alexsomesan/temp-controller/hardware/fridge-controller.kicad_pcb

## KiCad design hardware/fridge-controller.kicad_pcb (2021-08-09)

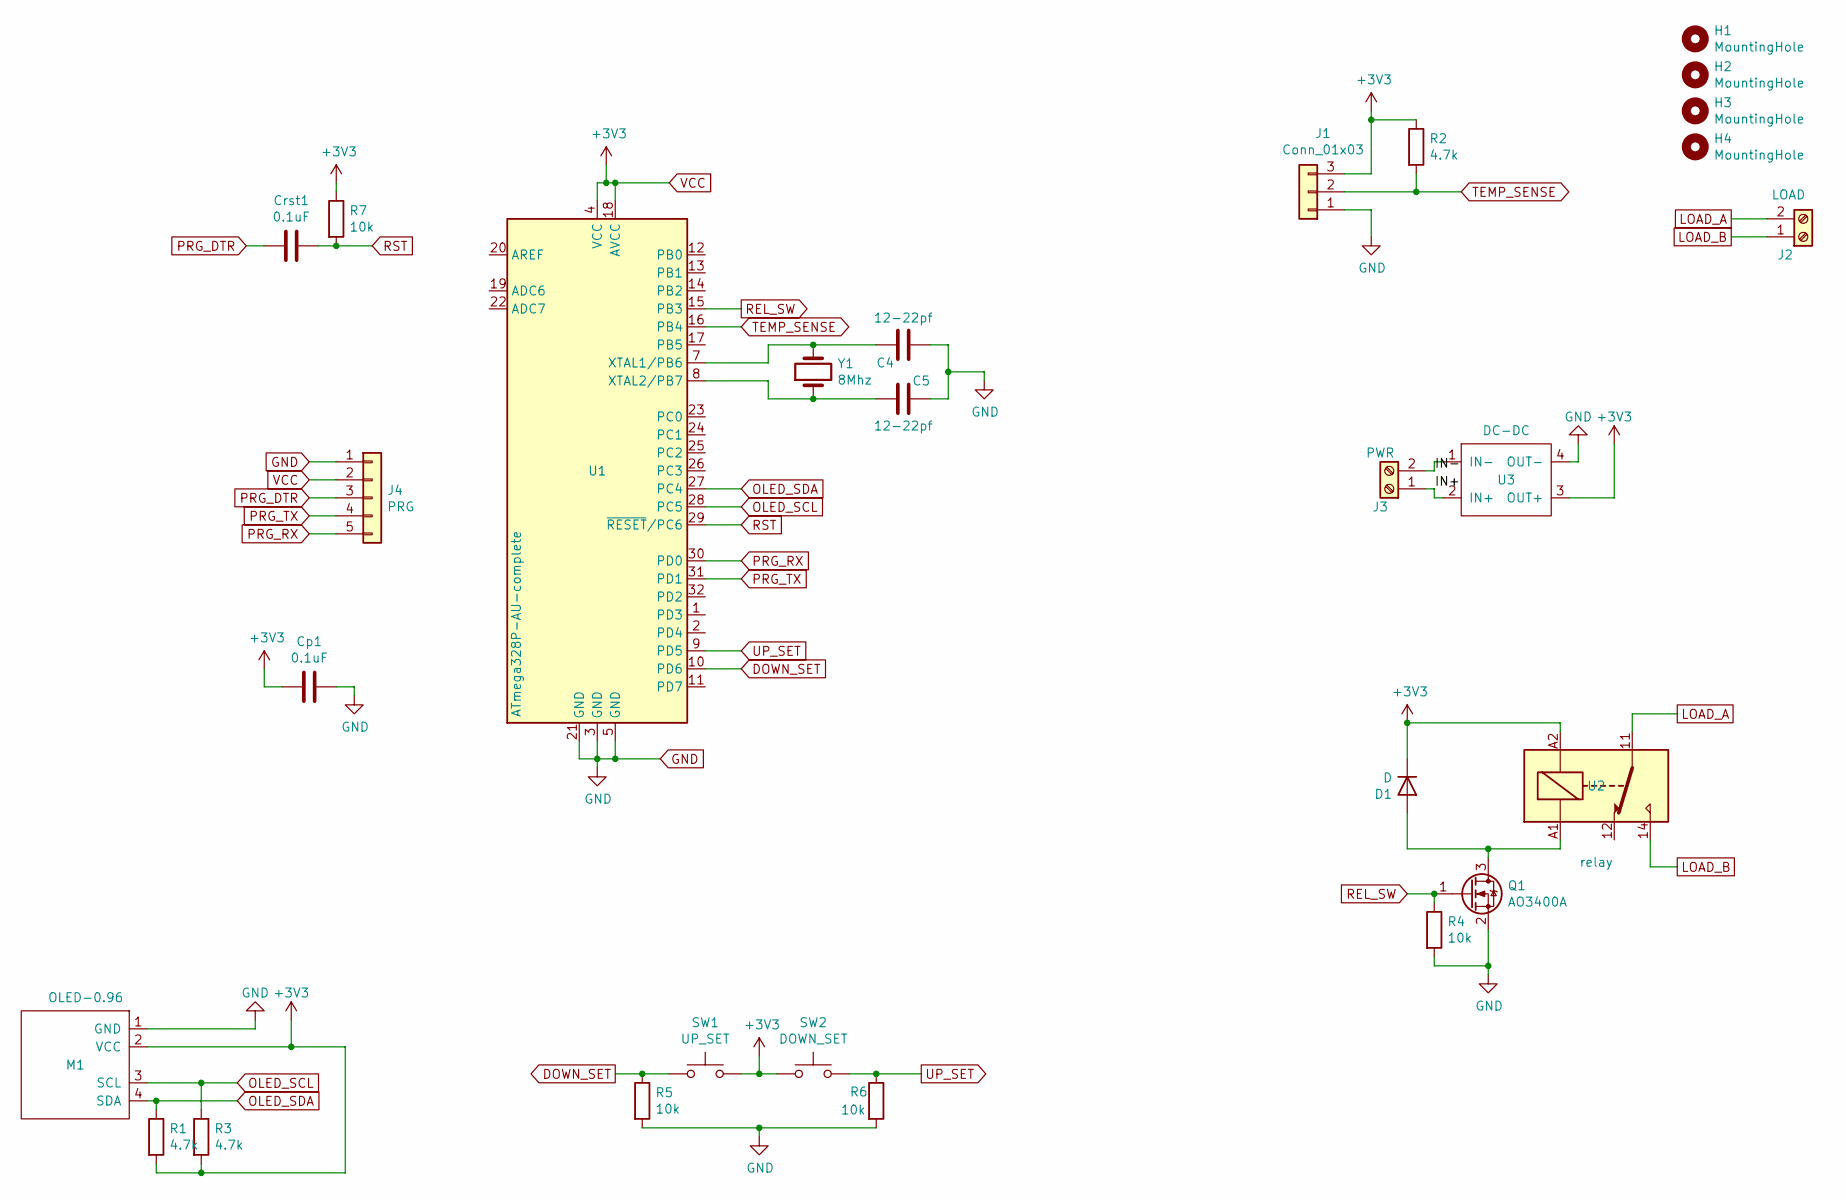
[picture p1: schematic fridge-controller.sch]

Parts:
C4, C5: 12-22pf; R_1206_3216Metric_Pad1.30x1.75mm_HandSolder
Cp1: 0.1uF; R_1206_3216Metric_Pad1.30x1.75mm_HandSolder
Crst1: 0.1uF; R_1206_3216Metric_Pad1.30x1.75mm_HandSolder
D1: D; R_1206_3216Metric_Pad1.30x1.75mm_HandSolder
H1, H2, H3, H4: MountingHole; MountingHole_2.1mm
J1: Conn_01x03; JST_XH_B3B-XH-A_1x03_P2.50mm_Vertical
J2: LOAD; TerminalBlock_Phoenix_PT-1,5-2-5.0-H_1x02_P5.00mm_Horizontal
J3: PWR; TerminalBlock_Phoenix_PT-1,5-2-5.0-H_1x02_P5.00mm_Horizontal
J4: PRG; PinHeader_1x05_P1.27mm_Vertical
M1: OLED-0.96
Q1: AO3400A; SOT-23
R1, R2, R3: 4.7k; R_1206_3216Metric_Pad1.30x1.75mm_HandSolder
R4, R5, R6, R7: 10k; R_1206_3216Metric_Pad1.30x1.75mm_HandSolder
SW1: UP_SET; SW_PUSH_6mm_H8mm
SW2: DOWN_SET; SW_PUSH_6mm_H8mm
U1: ATmega328P-AU-complete; TQFP-32_7x7mm_P0.8mm
U2: relay; Relay_SPDT_Finder_36.11
U3: DC-DC
Y1: 8Mhz; Crystal_HC49-4H_Vertical

Connections:
/IN+: J3.1, U3.2 (IN+)
/IN-: J3.2, U3.1 (IN-)
DOWN_SET: R5.1, SW1.1, U1.10 (PD6)
GND: C4.1, C5.1, Cp1.1, J1.1, J4.1, M1.1 (GND), Q1.2 (S), R4.2, R5.2, R6.2, U1.3 (GND), U1.5 (GND), U1.21 (GND), U3.4 (OUT-)
LOAD_A: J2.2, U2.11
LOAD_B: J2.1, U2.14
unnamed: C4.2, U1.7 (XTAL1/PB6), Y1.2
unnamed: C5.2, U1.8 (XTAL2/PB7), Y1.1
unnamed: D1.2 (A), Q1.3 (D), U2.A1
OLED_SCL: M1.3 (SCL), R3.1, U1.28 (PC5)
OLED_SDA: M1.4 (SDA), R1.1, U1.27 (PC4)
PRG_DTR: Crst1.2, J4.3
PRG_RX: J4.5, U1.30 (PD0)
PRG_TX: J4.4, U1.31 (PD1)
REL_SW: Q1.1 (G), R4.1, U1.15 (PB3)
RST: Crst1.1, R7.2, U1.29 (~RESET~/PC6)
TEMP_SENSE: J1.2, R2.2, U1.16 (PB4)
UP_SET: R6.1, SW2.1, U1.9 (PD5)
VCC: Cp1.2, D1.1 (K), J1.3, J4.2, M1.2 (VCC), R1.2, R2.1, R3.2, R7.1, SW1.2, SW2.2, U1.4 (VCC), U1.6 (VCC), U1.18 (AVCC), U2.A2, U3.3 (OUT+)

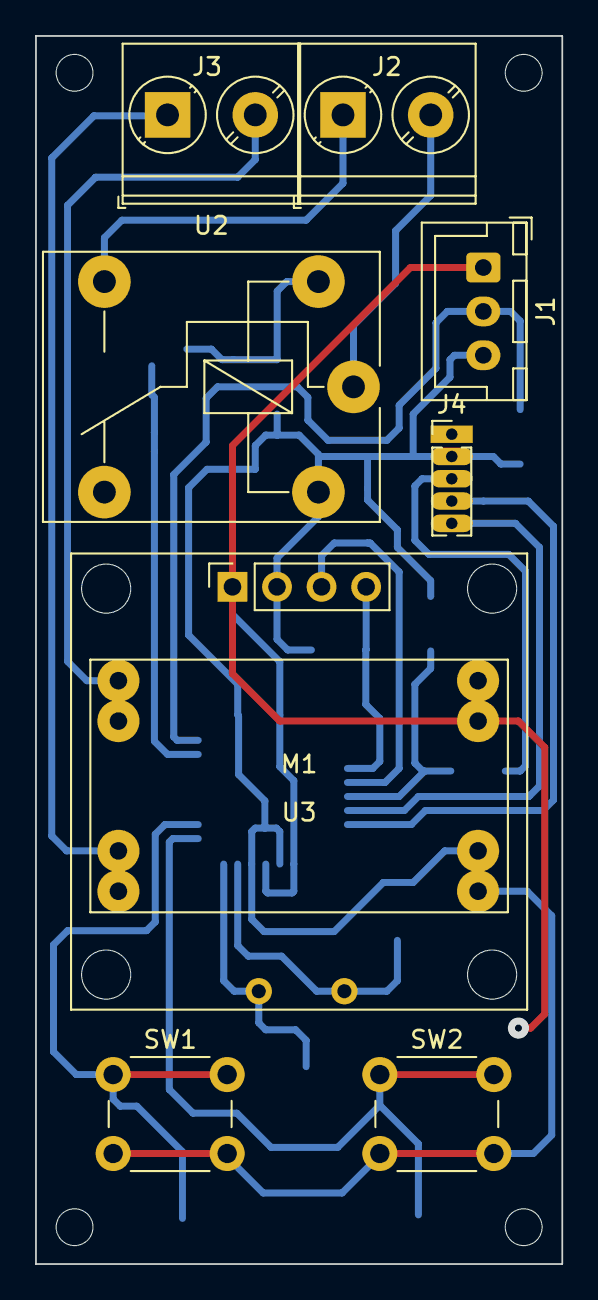
[picture p2: board fridge-controller.kicad_pcb from above]

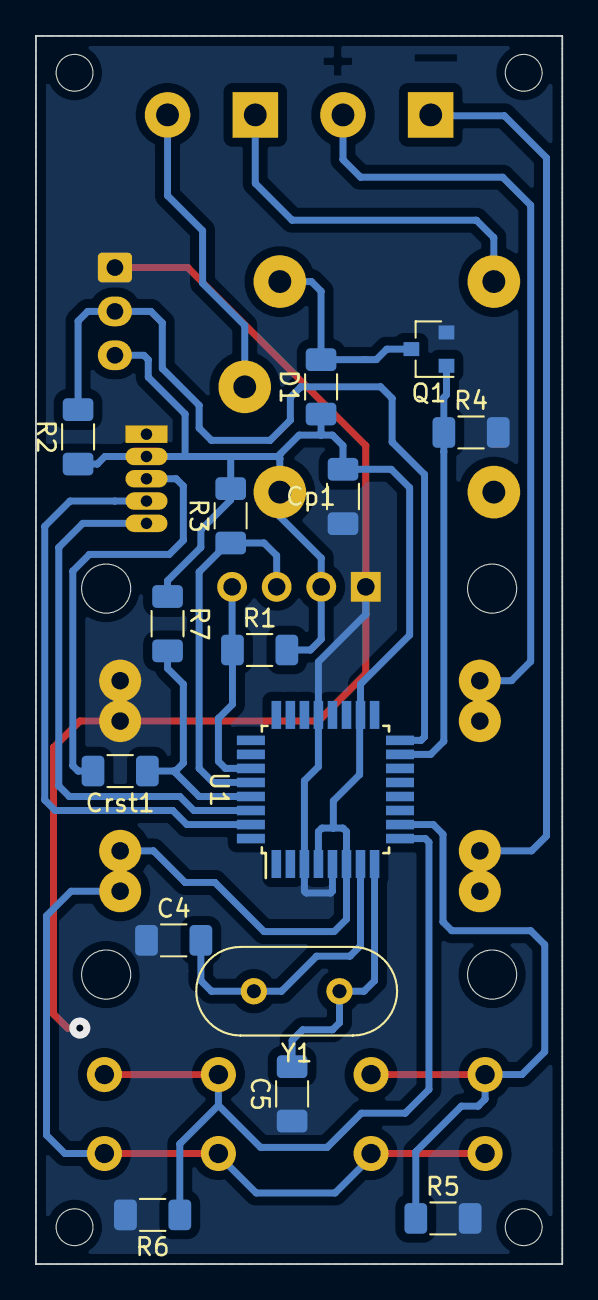
[picture p3: board fridge-controller.kicad_pcb from below]

Board: 2 copper layers, 30.0 x 70.0 mm, 28 parts (15 on the bottom side), 19 nets.
