alexsomesan/temp-controller/(commit log)

2021-07-30 working prototype
2021-08-09 Handle button inputs & save to EEPROM
2021-08-09 Combine hardware and firmware
    [fridge-controller.kicad_pcb, fridge-controller.sch]
2021-08-09 Optimize buttons responsiveness
